malbersmain-netizen/agentpad/schematics.html

# Schematics & board layout

Circuit, pin map, both sides of the board, component detail, every wire, then one figure per solder step.

One double-sided board, 30 × 42 holes. Everything lives on it: the control surface in columns 1–28, the ESP32 in a socket at columns 30–40 with its USB overhanging the edge. All soldering is done on one face, so the design works whether or not the holes are plated through. The ESP32 and the LCD both unplug — only the board is permanent.

Verified in millimetres, not hole counts. Every figure here is generated from tools/layout.py, the same file tools/verify-layout.py checks — so a drawing cannot disagree with the spec. Re-check with mise exec -- python tools/verify-layout.py.

## 1 · Circuit schematic

Three functional groups. LEDs: GPIO → 220Ω → LED → GND. Buttons: GPIO → switch → GND, with the ESP32's internal pull-up doing the rest. LCD: I²C on GPIO 21/22, powered from 5V.

## 2 · Pin map

16 connections. Every GPIO is safe: none are input-only (34-39) or boot strapping pins (0, 2, 12, 15). The 12 signal wires and the ground wire are soldered to socket pads; the LCD's 4 reach the board's LCD port on F-M jumpers.

## 3 · Board layout — top side, finished

One 30×42 double-sided board. The ESP32 is socketed at columns 30-40 on this same board; every wire is drawn on its real route. Red ✕ marks the switch leg you clip off.

## 3b · How it sits on the wood

Two pieces screw to the plate: the board, and the LCD. The ESP32 is socketed on the board itself, USB facing an edge. Only the board is permanent.

## 4 · Underside — where every joint lives

**This view is MIRRORED** — flip the board over and column 1 is on the right, so the numbers run 42 → 1. The board is double-sided, but every joint is made on this one face, which is what makes the design independent of whether your holes are plated through.

## 5 · Component detail — which holes exactly

Each switch has four legs but only two internally-joined pairs — and on this kit they join down the LONG axis. One leg is CLIPPED OFF before seating so the board works either way.

## 6 · Connection list

Tick these off as you go. Label both ends of every wire before you solder the second end.

## Step 1 — the buses and the ESP32 socket

Bare wire along rows 8, 16, 21 (all GND), spanning columns 1-28 and linked down column 1. Then the two 15-way socket strips at columns 30 and 40, rows 8-22. Test: every point on a bus beeps to every other; no bus beeps to a signal row.

## Step 2 — LEDs and resistors

Anode row 2, cathode row 3; the cathode lead bends flat on the copper face onto the row-4 pad, where the 220R starts. The resistor's other lead sits in row 8 — a GND bus — so it grounds itself. Columns 4, 11, 18, 25. Test: plug the ESP32 in, run firmware/ledtest — all four cycle.

## Step 3 — the four colored buttons

Legs in rows 11 and 16, left columns 3, 10, 17, 24 (each spans 2 columns). CLIP the leg at the signal column on row 16 before seating — three legs go in. The row-11 signal leg takes the wire; the diagonally opposite leg lands on the row-16 bus. Test: firmware/btntest prints button 0-3.

## Step 4 — AA / no / yes

Small 3x3 buttons, legs in rows 19 and 21, left columns 4, 13, 22. Same clip-one-leg rule. These are square, so orientation does not matter. Test: btntest prints button 0-6. Several dead at once means the GND bus, not the switches.

## Step 5 — the 12 wires, then the LCD

Every signal wire runs along its own row to the riser lane at column 29, then into its socket pad; the four that serve right-hand pins carry on underneath the module. Last, the 4-pin LCD port at cols 30-33 row 2 and its four wires — the LCD plugs into it on F-M jumpers and is never soldered. Test: firmware/lcdtest prints 'found device at 0x27'.
