malbersmain-netizen/agentpad/daemon.py

"""Agent Pad daemon (self-contained: all control on the board, no game controller).

Flow:
  - Color buttons (serial "B 0".."B 3") launch a color-tinted tmux window running
    `claude` if that agent isn't running yet, then focus it.
  - Approve / Deny buttons (serial "B 4" / "B 5") send a keystroke to the agent whose
    window is on screen -- but ONLY when it is genuinely blocked (safety interlock).
  - Claude Code hooks append to events.jsonl (pane + state); the daemon lights the
    matching LED and updates the LCD.

`blocked` comes from the PermissionRequest hook, which fires exactly when a permission
prompt is shown -- instantly, and for every prompt type. Do NOT switch this back to the
Notification hook: measured on this hardware, Notification fires 6.00s AFTER the prompt
renders (it exists to chase a user who walked away), which made the pad useless.

Run it in its own terminal, then attach to the session in another:
    tmux attach -t agentpad
"""
import json, os, re, time, subprocess, threading
import serial

# ===== CONFIG =====
PORT     = "/dev/cu.usbserial-0001"     # confirmed on this build
SESSION  = "agentpad"                    # tmux session name
APPROVE  = "1"                           # keystroke: "Yes"
DENY     = "3"                           # keystroke: "No"
ALWAYS   = "2"                           # keystroke: "Yes, and don't ask again"
# Agent windows must keep NORMAL permissions even when the user's own settings say
# bypassPermissions -- otherwise nothing ever prompts, `blocked` never fires, and the
# LEDs and approve/deny buttons have nothing to do. This flag is the whole demo.
CLAUDE   = "claude --permission-mode manual"
# Derived from this file's own location, not hardcoded. The repo moved once
# (~/projects -> ~/github) and every absolute path in it had to be chased down; deriving
# means the next move is free.
HERE     = os.path.dirname(os.path.abspath(__file__))
EVENTS   = os.path.join(HERE, "events.jsonl")
CONTEXT  = os.path.join(HERE, "context.jsonl")
LOGFILE  = os.path.join(HERE, "daemon.log")
# per-agent identity (index 0-3 = red, green, blue, yellow)
NAMES  = ["A1-red", "A2-grn", "A3-blu", "A4-ylw"]
COLORS = ["colour52", "colour22", "colour17", "colour58"]  # dark tint per window
STATES = {"none", "idle", "working", "blocked", "done"}
# ==================

ser_lock = threading.Lock()   # serial is shared by several threads
lcd_lock = threading.Lock()   # refresh() writes two rows; keep them as one update
ser = None

def open_serial(quiet=False):
    """Open the board, waiting for it to appear. The ESP32 re-enumerates whenever the
    cable is nudged; a demo should survive that instead of dying at startup."""
    global ser
    while True:
        try:
            ser = serial.Serial(PORT, 115200, timeout=0.1)
            time.sleep(2)                      # board reboots when the port opens
            log(f"serial open on {PORT}")
            return
        except Exception as exc:
            if not quiet:
                print(f"waiting for {PORT} ... ({exc.__class__.__name__})")
                quiet = True
            time.sleep(1)

slots     = [None] * 4     # agent index -> tmux pane id (once launched)
pane_slot = {}             # pane id -> agent index
info      = {}             # pane id -> {"state":..., "since":..., "prev":...}
ctx_pct   = {}             # pane id -> context-window usage %
focus     = 0
gauge_shown = None         # last value sent to the bar graph
answered_at = {}           # pane -> time we last sent a keystroke (double-fire guard)

def log(msg):
    try:
        with open(LOGFILE, "a") as f:
            f.write(f"{time.strftime('%H:%M:%S')} {msg}\n")
    except OSError:
        pass

def send(line):
    with ser_lock:
        try:
            ser.write((line + "\n").encode())
        except Exception:
            pass          # board unplugged; read_serial owns reconnecting

def tmux(*args):
    return subprocess.run(["tmux", *args], capture_output=True, text=True)

def set_state(pane, i, st, keep_prev=None):
    """Record a state change and push it to the LED. Resets the timer only when the
    state actually changes, so repeat events don't restart the clock."""
    prev = info.get(pane)
    if not prev or prev["state"] != st:
        info[pane] = {"state": st, "since": time.time(),
                      "prev": keep_prev if keep_prev is not None
                      else (prev or {}).get("state", "idle")}
    else:
        prev["state"] = st
    send(f"L {i} {st}")

def ensure_session():
    """Create the session (with a placeholder 'home' window) so you can attach
    immediately and watch agent windows appear as you press buttons."""
    if tmux("has-session", "-t", SESSION).returncode != 0:
        tmux("new-session", "-d", "-s", SESSION, "-n", "home")

def sync_slots():
    """Bind each agent window's pane to its slot BY NAME. Authoritative and
    idempotent, so color/slot stays correct even after a daemon restart (when the
    windows already exist and we never re-spawn them)."""
    if tmux("has-session", "-t", SESSION).returncode != 0:
        return
    r = tmux("list-windows", "-t", SESSION, "-F", "#{window_name}\t#{pane_id}")
    if r.returncode != 0:
        return                         # tmux hiccup: keep what we have, never clear
    live = {}
    for line in r.stdout.splitlines():
        parts = line.split("\t")
        if len(parts) != 2:
            continue
        name, pane = parts
        if name in NAMES:
            live[NAMES.index(name)] = pane
    for i, pane in live.items():
        old = slots[i]
        if old and old != pane:
            pane_slot.pop(old, None)   # window respawned: drop the orphan mapping
            info.pop(old, None)
            ctx_pct.pop(old, None)
            answered_at.pop(old, None)
        slots[i] = pane
        pane_slot[pane] = i
    # Close an agent window and its slot used to keep the dead pane forever: the LED
    # stayed lit on a stale state, watch_prompts kept capture-pane'ing a pane that no
    # longer exists, and respond() could aim a keystroke at it. Drop it and dark the LED.
    for i in range(4):
        if i not in live and slots[i]:
            dead = slots[i]
            pane_slot.pop(dead, None)
            info.pop(dead, None)
            ctx_pct.pop(dead, None)
            answered_at.pop(dead, None)
            slots[i] = None
            send(f"L {i} none")
            log(f"agent {i} window closed -- slot released (was {dead})")

def state_of(i):
    p = slots[i]
    return info[p]["state"] if p and p in info else "none"

def refresh():
    letters = {"none": "-", "idle": "i", "working": "w", "blocked": "B", "done": "d"}
    p = slots[focus]
    if p and p in info:
        secs = int(time.time() - info[p]["since"])
        row0 = f"A{focus+1} {info[p]['state'].upper()[:7]} {secs//60}:{secs%60:02d}"
    else:
        row0 = f"A{focus+1} --"
    row1 = " ".join(f"{i+1}{letters.get(state_of(i), '?')}" for i in range(4))
    # "1w 2B 3i 4d" is 11 of 16 chars, so the focused agent's context usage fits in
    # the tail. Costs no hardware, and doubles as a fallback if the bar graph isn't wired.
    used = ctx_pct.get(p) if p else None
    if used is not None:
        row1 = f"{row1} {used}%"
    # Both rows as one unit. refresh() is called from four threads, and interleaving
    # two calls leaves row 1 describing a state row 0 has already moved past.
    with lcd_lock:
        send(f"D0 {row0[:16]}")
        send(f"D1 {row1[:16]}")

def _spawn(i):
    """Create the tmux window for agent i running claude; record its pane id."""
    if tmux("has-session", "-t", SESSION).returncode != 0:
        r = tmux("new-session", "-d", "-s", SESSION, "-n", NAMES[i],
                 "-P", "-F", "#{pane_id}", CLAUDE)
    else:
        r = tmux("new-window", "-t", SESSION, "-n", NAMES[i],
                 "-P", "-F", "#{pane_id}", CLAUDE)
    pane = r.stdout.strip()
    if pane:
        slots[i] = pane
        pane_slot[pane] = i
    # tint the whole window so you can tell agents apart at a glance
    tmux("set-option", "-w", "-t", f"{SESSION}:{NAMES[i]}", "window-style",
         f"bg={COLORS[i]}")

def launch_or_focus(i):
    global focus
    wins = []
    if tmux("has-session", "-t", SESSION).returncode == 0:
        wins = tmux("list-windows", "-t", SESSION,
                    "-F", "#{window_name}").stdout.splitlines()
    if NAMES[i] not in wins:
        _spawn(i)
    sync_slots()   # keep color/slot binding authoritative
    tmux("select-window", "-t", f"{SESSION}:{NAMES[i]}")
    focus = i
    refresh()

def active_slot():
    """Agent slot whose tmux window is currently active, or None if not an agent
    window. Lets the pad follow tmux even when you switch windows by hand."""
    name = tmux("display-message", "-p", "-t", SESSION, "#{window_name}").stdout.strip()
    return NAMES.index(name) if name in NAMES else None

# A selection prompt renders as numbered option rows with a ">" cursor on the current
# one. Matching that STRUCTURE (rather than wording) covers every prompt shape --
# tool permission, plan approval, compaction, trust dialogs, AskUserQuestion -- without
# depending on prose that Claude might merely be talking about.
OPTION_RE   = re.compile(r"^\s*❯?\s*[1-9]\.\s+\S")   # "  2. No"
SELECTED_RE = re.compile(r"^\s*❯\s*[1-9]\.\s+\S")    # "❯ 1. Yes"  <- only a live menu

def prompt_visible(pane):
    """True if a live selection prompt is on that pane's screen RIGHT NOW.

    Requires a selected option row AND at least two options. The input box also
    starts with "❯", so the cursor alone is not enough -- it must sit on a numbered
    option, which normal output never does.
    """
    r = tmux("capture-pane", "-p", "-t", pane)
    if r.returncode != 0:
        return False
    lines = r.stdout.splitlines()
    # Claude Code pads the screen with blank lines BELOW the prompt -- 17 of them on a
    # 42-row pane, measured. Taking a fixed tail of the raw capture then slices the
    # prompt in half: you see "3. No" but not the "> 1. Yes" selected row above it, and
    # conclude nothing is waiting. Trim the padding first, then look at real content.
    while lines and not lines[-1].strip():
        lines.pop()
    tail = lines[-20:]
    return (any(SELECTED_RE.match(l) for l in tail)
            and sum(1 for l in tail if OPTION_RE.match(l)) >= 2)

def respond(keystroke):
    """Answer the prompt on the agent that is actually on screen."""
    global focus
    i = active_slot()
    if i is None:
        # not looking at an agent window -- refuse rather than guess a target
        log(f"respond({keystroke!r}) refused: active window is not an agent")
        send("D0 no agent focused")
        time.sleep(0.6)
        refresh()
        return
    focus = i
    p = slots[focus]
    # Small grace window: the hook and the button race by a few ms.
    if p and info.get(p, {}).get("state") != "blocked":
        deadline = time.time() + 0.4
        while time.time() < deadline and info.get(p, {}).get("state") != "blocked":
            time.sleep(0.02)
    st = info.get(p, {}).get("state") if p else None
    snapshot = {k: v["state"] for k, v in list(info.items())}
    # Two independent conditions must agree before we type anything: the hook says
    # blocked AND a prompt is on screen right now. Either alone can be stale.
    on_screen = prompt_visible(p) if p else False
    log(f"respond({keystroke!r}) slot={i} pane={p} state={st} on_screen={on_screen} "
        f"info={snapshot}")
    if not p or st != "blocked" or not on_screen:
        send("D0 not blocked")
        time.sleep(0.6)
        refresh()
        return
    r = tmux("send-keys", "-t", p, keystroke, "Enter")
    # Clear immediately so a second press can't re-fire into the now-normal input box.
    # The screen does not clear instantly though, so also suppress screen-detection on
    # this pane briefly -- otherwise the next 200ms poll still sees the old menu, marks
    # it blocked again, and a double press types a second keystroke into whatever has
    # replaced the prompt.
    answered_at[p] = time.time()
    set_state(p, i, "working")
    refresh()
    log(f"  sent {keystroke!r} to {p} rc={r.returncode} err={r.stderr.strip()!r}")

def slot_of(pane):
    """Map a hook's pane to an agent slot. Only panes we launched count -- the hooks
    are global, so every Claude session on the machine writes to events.jsonl and a
    stranger must never be able to claim a slot (or receive our keystrokes)."""
    return pane_slot.get(pane)

def tail_events():
    open(EVENTS, "a").close()
    with open(EVENTS, "r") as f:
        f.seek(0, 2)
        while True:
            # Remember where we were BEFORE reading. A text-mode file cannot do
            # cur-relative seeks -- f.seek(-len(line), SEEK_CUR) raises
            # UnsupportedOperation -- and len() counts characters, not bytes, so even
            # a binary handle would misalign on non-ASCII. tell()/seek() is the only
            # correct way to rewind past a partial write.
            pos  = f.tell()
            line = f.readline()
            if not line or not line.endswith("\n"):
                f.seek(pos)                  # partial write: re-read it whole next time
                time.sleep(0.02)
                continue
            try:
                e = json.loads(line)
            except Exception:
                continue
            pane = e.get("pane")
            if not pane:
                continue
            i = slot_of(pane)
            if i is None:
                continue
            st = e.get("state", "idle")
            if st not in STATES:
                continue
            set_state(pane, i, st)
            log(f"event pane={pane} slot={i} state={st}")
            refresh()

def read_serial():
    while True:
        try:
            line = ser.readline().decode(errors="ignore").strip()
        except Exception:
            log("serial lost -- reopening")
            try:
                ser.close()
            except Exception:
                pass
            open_serial(quiet=True)
            blank_leds()
            resync_leds()
            global gauge_shown
            gauge_shown = None
            push_gauge()
            continue
        if not line.startswith("B "):
            continue
        try:
            n = int(line.split()[1])
        except (IndexError, ValueError):
            continue
        if   0 <= n <= 3: launch_or_focus(n)
        elif n == 4:      respond(APPROVE)
        elif n == 5:      respond(DENY)
        elif n == 6:      respond(ALWAYS)

def watch_prompts():
    """Keep `blocked` in sync with what is actually on screen.

    PermissionRequest covers tool permissions instantly, but it is NOT the only thing
    that stops an agent: compaction dialogs, plan approval, trust prompts and
    AskUserQuestion all wait on you without being a tool permission. Matching the
    on-screen menu catches those too (within one 200ms poll), and also notices when
    any prompt has been answered.
    """
    while True:
        time.sleep(0.2)
        for i, p in enumerate(list(slots)):
            if not p:
                continue
            if time.time() - answered_at.get(p, 0) < 1.0:
                continue                  # just answered; let the screen catch up
            cur = info.get(p, {}).get("state")
            vis = prompt_visible(p)
            if vis and cur != "blocked":
                set_state(p, i, "blocked")
                log(f"screen-detect BLOCKED pane={p} slot={i} (was {cur})")
                refresh()
            elif not vis and cur == "blocked":
                back = info.get(p, {}).get("prev") or "working"
                if back == "blocked":
                    back = "working"
                set_state(p, i, back)
                log(f"prompt cleared pane={p} slot={i} -> {back}")
                refresh()

def push_gauge():
    """Drive the bar graph like a BATTERY: full = fresh context, empty = context spent.

    ctx_pct stores context *used*, so the lit portion is the remainder. An agent we
    have no reading for yet shows dark rather than falsely full.
    """
    global gauge_shown
    p = slots[focus]
    used = ctx_pct.get(p) if p else None
    charge = 0 if used is None else max(0, min(100, 100 - used))
    if charge != gauge_shown:
        gauge_shown = charge
        send(f"G {charge}")
        log(f"gauge slot={focus} used={used} -> charge {charge}%")

def tail_context():
    """Follow context.jsonl, written by the statusLine command in each agent."""
    open(CONTEXT, "a").close()
    with open(CONTEXT, "r") as f:
        f.seek(0, 2)
        while True:
            pos  = f.tell()                  # see tail_events: no cur-relative seeks
            line = f.readline()
            if not line or not line.endswith("\n"):
                f.seek(pos)
                time.sleep(0.1)
                continue
            try:
                e = json.loads(line)
                pane, pct = e["pane"], int(e["pct"])
            except Exception:
                continue
            if pane in pane_slot:
                ctx_pct[pane] = max(0, min(100, pct))
                push_gauge()

def tick():
    """Re-render the LCD every second so the state timer counts live, and follow
    whichever agent window tmux has active (you may switch windows by hand)."""
    global focus
    while True:
        time.sleep(1)
        sync_slots()          # notice windows the user closed by hand
        i = active_slot()
        if i is not None and i != focus:
            focus = i
        refresh()
        push_gauge()   # bar follows whichever agent you're looking at

def resync_leds():
    """Push current states to the board. Used after a reconnect, since the ESP32
    reboots with every LED off and no memory of what we last told it."""
    for i, p in enumerate(slots):
        if p and p in info:
            send(f"L {i} {info[p]['state']}")
    refresh()

def blank_leds():
    """Turn all four LEDs off. The ESP32 holds its last-known LED state across
    daemon restarts, so without this a fresh start shows stale lights."""
    for i in range(4):
        send(f"L {i} none")

def recover_state():
    """Rebuild last-known agent state from the events log so a daemon restart is
    seamless. `blocked` is deliberately NOT restored: a prompt from a previous run is
    long gone, and reviving it would open the interlock with nothing on screen."""
    try:
        # Only the tail matters -- this file is append-only across every session on the
        # machine and grows without bound, and the last state per pane is all we want.
        lines = open(EVENTS).read().splitlines()[-500:]
    except FileNotFoundError:
        return
    for line in lines:
        try:
            e = json.loads(line)
        except Exception:
            continue
        pane, st = e.get("pane"), e.get("state", "idle")
        if pane in pane_slot and st in STATES and st != "blocked":
            info[pane] = {"state": st, "since": time.time(), "prev": st}
    for pane, i in pane_slot.items():
        if pane in info:
            send(f"L {i} {info[pane]['state']}")

def supervise(fn):
    """Keep a worker alive. Without this one exception silently half-kills the daemon
    (e.g. buttons stop working) while the process still looks healthy."""
    def wrapper():
        while True:
            try:
                fn()
            except Exception as exc:
                log(f"!! {fn.__name__} crashed: {exc!r} -- restarting in 1s")
                time.sleep(1)
    return wrapper

open_serial()     # waits for the board rather than dying if it's unplugged
ensure_session()
blank_leds()      # clear stale LED state the board held from a previous run
sync_slots()      # bind existing agent windows to their color slots on startup
recover_state()   # restore last-known LED states (never `blocked`) after a restart
for worker in (tail_events, tail_context, read_serial, tick, watch_prompts):
    threading.Thread(target=supervise(worker), daemon=True).start()

refresh()
print("agentpad running. ctrl-c to quit.")
print(f"attach the board's sessions with:  tmux attach -t {SESSION}")

try:
    while True:
        time.sleep(0.2)
except KeyboardInterrupt:
    pass
finally:
    try:
        ser.close()
    except Exception:
        pass
