malbersmain-netizen/agentpad/(commit log)

2026-07-28 Initial commit: Agent Pad firmware, docs, and software scaffold
    Hardware build verified end-to-end (LCD, 4 LEDs, 4 buttons, serial protocol).
    - firmware/agentpad: real firmware (compiles + runs on ESP32)
    - firmware/{blink,lcdtest,ledtest,btntest}: milestone test sketches
    - daemon.py, pad.py, test.py: software scaffold (Milestones 6-9)
    - CLAUDE.md, agentpad-build-guide.md: project docs
    - mise.toml: Python 3.13 venv (pyserial, pygame)
2026-07-28 Self-contained control surface: 6 buttons, no game controller
    Redesign so the board alone drives everything (a true 'code micro' clone):
    - Firmware: 6 buttons (added APPROVE=GPIO19, DENY=GPIO18); protocol now B 0-5
    - Daemon: color buttons launch a color-tinted tmux 'claude' window and focus it;
    approve/deny send keystrokes to the focused agent behind the blocked interlock
    - Drop pygame from the daemon (pad.py kept for a possible later add-on)
    Fixes found during hardware testing:
    - Live 1s LCD timer, anchored to state CHANGE so repeat hook events don't reset it
    - sync_slots(): bind pane->slot by window name, so color/slot mapping survives a
    daemon restart (this was silently breaking appr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
    [agentpad.ino, daemon.py]
2026-07-28 Fix approve/deny race and follow the active tmux window
    Two real bugs found by instrumenting the daemon:
    1. Approve/deny targeted the last color button pressed, not the window actually
    on screen. Switching windows inside tmux aimed the keystroke at the wrong
    agent. Now resolved from tmux active window; the LCD follows it too.
    2. Race: the permission prompt renders slightly BEFORE the Notification hook
    reaches the daemon, so pressing approve immediately was refused on stale
    state (log showed refuse -> blocked event -> accept, all in one second).
    The interlock now waits up to 1.5s for to arrive. It still never
    sends a keystroke unless the agent really is blocked.
    Adds dae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
    [daemon.py]
2026-07-28 Detect blocked from the screen, not the Notification hook (6.00s -> 0.24s)
    Measured on real hardware: the Notification hook fires 6.00s AFTER the permission
    prompt renders. That is by design -- notifications exist to chase a user who has
    walked away -- but it is far too slow for a status light, and it was the actual
    cause of "approve does not work": the pad was still showing the previous state
    when the user's thumb got there.
    Fix: poll each agent pane with tmux capture-pane (200ms) and treat a visible
    permission prompt as authoritative for `blocked`. Hook `blocked` events are now
    ignored entirely so the stale 6s-late event cannot re-trigger after the prompt is
    answered; hooks still drive id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
    [daemon.py]
2026-07-28 Remove the controller entirely; bring docs in line with the built device
    The device is a single self-contained unit, so the game-controller path is gone
    rather than deferred: delete pad.py, drop pygame from the dependencies, and strip
    the controller from both docs.
    Docs were describing the original design and would not have produced a working
    build. Rewrote agentpad-build-guide.md against the real implementation:
    - six buttons throughout, with APPROVE=GPIO19 / DENY=GPIO18 added to the pin
    table and the test sketch (the guide previously never had you wire them at all)
    - deleted the obsolete pygame daemon listing; daemon.py is now described, not
    duplicated, so it cannot drift again
    - the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
2026-07-28 Catch non-permission dialogs, add always-allow button, feed context% to a gauge
    PermissionRequest only covers TOOL permissions. Compaction dialogs, plan approval,
    trust prompts, /model and AskUserQuestion all block an agent without being a tool
    permission, so the LED stayed dark and approve/deny refused. The screen watcher now
    SETS blocked as well as clearing it, matching menu structure rather than wording.
    Verified against /model (fires no PermissionRequest): "screen-detect BLOCKED".
    To keep that from false-positiving on Claude's own prose, a match now requires the
    cursor to sit ON a numbered option ("> 1. Yes"), not merely a numbered list -- the
    input box also starts with ">", so the curs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
2026-07-28 Show context % on the LCD; descope the bar graph; add BUILD.md
    Context-window usage now appears on the LCD bottom row ("1w 2B 3i 4d 34%"), which
    needs no hardware at all -- the row was only using 11 of 16 characters. Sourced from
    the statusLine payload, the one place Claude Code exposes context_window usage.
    Bar graph descoped at the user's request: it needed a 74HC595 (the kit is a Raspberry
    Pi kit, which has enough GPIOs to drive all 10 segments directly -- we don't), plus
    board space that is already spoken for. The firmware keeps the `G` command and
    reserves GPIO 5/16/17, so it can be added later without touching anything else.
    BUILD.md: checklist for the soldered/cased build. Two rules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
2026-07-28 BUILD.md: mounting decision, shopping list, wiring harness map, solder order
    Adds the full harness table (15 signal wires with suggested colors and labels), a
    bus-first perfboard strategy mirroring the breadboard rails, and a 7-step solder
    order where each step has an explicit pass condition using the existing milestone
    sketches.
    Mounting is decided by the kit: its buttons and LEDs are breadboard parts with no
    collar or bezel, so they must be board-mounted poking through the face, while the
    LCD has mounting holes and panel-mounts on flying leads. Since we are designing the
    case, it should be laid out on the perfboard's 0.1in grid so alignment is guaranteed
    rather than hoped for. Records the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
2026-07-28 Add tools/view-plan.py: render BUILD.md as a tickable bench checklist
    Renders BUILD.md (still the single source of truth -- no duplicated copy to drift)
    into a styled page with per-row checkboxes that persist in localStorage, so the build
    can be ticked through across sessions. Light/dark aware and printable.
    mise exec -- python tools/view-plan.py
2026-07-28 Add illustrated build figures; record case fit findings
    tools/build-figures.py draws the case to scale and one figure per solder step
    (header+buses, LCD, LEDs, buttons) plus detail insets for LED polarity, the button
    diagonal-leg rule, and good vs cold joints.
    Checking the 95x140x28mm design against real part dimensions found two problems:
    - Depth: stacking the ESP32 under the perfboard needs 32.7mm and will not close in a
    28mm case. Coplanar comes to 24.2mm. The ESP32 therefore needs a ~30x60mm free zone;
    the empty middle band is ~24mm today and should be opened up.
    - LCD: the 80x36mm figure is the MODULE outline. Cutting that size drops the module
    through the face. The window shoul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
2026-07-28 BUILD.md: rewrite as a complete end-to-end build manual
    Previous version was a checklist plus figures, not an instruction set. Now covers the
    whole path: parts, case spec with real hole coordinates, perfboard grid plan, a
    soldering primer for a first-timer, seven build steps each with a pass condition,
    case assembly, software install, an acceptance test, and troubleshooting.
    Corrects an earlier claim: the middle band does NOT need opening. Working out real
    coordinates shows the ESP32 fits vertically in the bottom-centre with AA to its left
    and no/yes to its right -- which is how the case was already drawn. Depth still
    requires it coplanar rather than stacked (24.2mm vs 32.7mm in a 28mm case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
2026-07-28 Add printable 3D case (OpenSCAD) and an assembly guide
    case/agentpad-case.scad: parametric two-part enclosure -- printed face plate with all
    cutouts, and a box with walls, board standoffs, corner posts and a USB slot. Renders to
    face.stl / box.stl (gitignored; regenerate from the .scad).
    Render headless (Qt needs a display otherwise):
    QT_QPA_PLATFORM=offscreen openscad -o face.stl -D 'PART="face"' case/agentpad-case.scad
    The model computes its own depth and reports the fit. Two findings from it:
    - Total thickness 25.2mm, so the 28mm design has room.
    - The face gap is set by the ESP32 (13.6mm), not the button caps (12.5mm), so the
    buttons need a ~1.1mm shim -- or 5mm low-profile headers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
    [agentpad-case.scad]
2026-07-28 Correct the perfboard claim; document the 3mm span problem
    The kit DOES include three PY-5CM*7CM perfboards -- my earlier claim that it only
    had a solderless breadboard was wrong, taken from a contents sheet that listed only
    the Project Board.
    They are still unusable here, but for a different and more concrete reason: the
    select-button row spans 73mm outer-edge and the answer row 75.5mm, while the widest
    kit board is 70mm. Button positions are fixed by the case face, so this is geometry,
    not packing. Records the three ways out (buy one 9x15cm, narrow the pitch to 7 holes
    and re-render the case, or split across boards with wire looms).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
2026-07-28 Narrow pitch to 6 holes (15.24mm) to fit the kit's 18x24 perfboards
    Board confirmed as 18 x 24 holes (a-x by 1-18), so the hole field is 58.4mm and the
    old 8-hole pitch (73mm span) was never going to work. Pitch is now driven by a single
    PITCH_HOLES parameter in the .scad; every hole position and the answer-row placement
    derive from it, so the face and the board grid stay in agreement.
    New columns: 24.64 / 39.88 / 55.12 / 70.36mm. AA sits under column 1 and no/yes under
    columns 3 and 4, which keeps AA 30.5mm away from 'yes' so it can't be fat-fingered.
    Consequence to design around: at 18 rows per board, no single kit board can hold the
    LED/button cluster (9 rows), the ESP32 (15 rows) and t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
    [agentpad-case.scad]
2026-07-28 Single-board layout: everything fits on one kit board after all
    I was wrong twice about this. First I said the kit had no perfboard; it has three.
    Then I said the design needed splitting across three of them. Both wrong.
    It fits on ONE 18x24 board because the ESP32 is socketed and hangs UNDERNEATH -- it
    consumes only two rows of holes (the header) instead of an 11x15 block of top-side
    area. Rows 2 and 11 carry the header; the LED/button clusters are placed specifically
    to leave those two rows free. Button legs protrude ~3mm below the board and the ESP32
    sits 8.5mm below on its header, so nothing collides. The ESP32's USB overhangs the
    board edge, which makes the cable easier to reach, not h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
2026-07-28 Verify the single-board layout, add schematics and a soldering course
    tools/verify-layout.py checks the layout in millimetres rather than hole counts -- a
    12mm button body is 4.7 holes wide, so parts collide even when their legs sit in free
    holes. It immediately caught one: the standing 220R and the LED body fought for the
    same column. Resistors moved two columns right; now PASS, with 3.2mm between button
    caps, 2.9mm LED->button and 6.2mm between the two banks.
    Confirmed: all 7 buttons, 4 LEDs, 4 resistors and the ESP32 fit ONE 18x24 kit board.
    tools/schematic.py draws the circuit schematic, the finished board, and one board
    figure per solder step, all from the same layout data the verifie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
    [schematic.py, verify-layout.py]
2026-07-28 Correct button footprints to measured values; expand the schematic set
    Measured on the real parts: the colored buttons' legs are 5 holes apart in BOTH
    directions (a 5x5 span, 12.7mm), not the 2-hole span I had modelled, and the small
    buttons are 3x3. Re-verified against those numbers.
    It still fits one board, and the column arithmetic turns out to be exact: four buttons
    with 5-hole legs at a 6-column pitch occupy columns 1-6, 7-12, 13-18, 19-24 -- all 24
    columns with nothing to spare. Clearances improved: 3.2mm between button bodies, 4.2mm
    LED->button, 7.5mm between banks. Row plan is now
    1 res | 2 HEADER | 3-4 LED | 5 GND | 6-11 buttons | 12 HEADER | 14-16 answers | 17 GND | 18 5V+LCD.
    Sc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
    [schematic.py, verify-layout.py]
2026-07-28 Use the measured button pin geometry (3 across x 6 long)
    Third correction to these footprints, and this one is from calipers rather than a
    datasheet guess: the colored buttons' pins are 3 holes ACROSS (2 pitches, 5.08mm) and
    6 holes LONG (5 pitches, 12.7mm) -- a rectangle, not the 5x5 square I had modelled.
    Small buttons are 3x3.
    This is better than the previous model. Legs now occupy only 3 columns each, so the
    board is no longer packed to exactly 24 columns; the 12mm bodies overhang their own
    legs and sit 3.24mm apart. The header moved to rows 4 and 13, which frees rows 1-3
    entirely for the LEDs and their resistors and keeps both header rows clear of every
    component body. LED->button clea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
    [schematic.py, verify-layout.py]
2026-07-28 Add BREADBOARD.md; re-solve the row plan for 1.0in ESP32 pin rows
    The ESP32 measures 11 holes across x 15 long, so its pin rows are 10 apart (1.0 inch),
    not the 0.9 inch I had assumed. That invalidated the header placement. Rather than
    guess again, a small search enumerated every arrangement satisfying all the physical
    constraints -- header rows exactly 10 apart, both clear of leads AND not sitting under
    any component body (their solder joints protrude on the top side, so a button resting
    on them would not lie flat). Exactly two arrangements survive; this is the roomier one.
    Row plan: 1 5V | 2 resistors (flat) | 3-4 LEDs | 5 GND | 6 HEADER-A |
    7+12 button legs | 13+15 answer legs | 16 HEADE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
2026-07-28 Header is a stacking type: document orientation and the alignment trick
    The kit's 40-pin header has sockets on one face and long pins on the other. It works,
    but the orientation is counter-intuitive and effectively one-way: the strips go in from
    UNDERNEATH so the pins come up through the board and the sockets hang below, then get
    soldered from the top and trimmed. Sockets facing down is what lets the ESP32 plug in
    from below, which is the only reason the whole design fits one board.
    Also records the assembly order that makes misalignment impossible: plug both strips
    onto the ESP32 first and insert the assembly as one unit, so the ESP32 itself holds the
    spacing and squareness while you solde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
2026-07-28 Two-board build on a wooden plate; single-sided board drives the design
    The kit's perfboards are SINGLE-SIDED -- copper on one face only, so every joint is on
    that face and components sit on the other. I had assumed plated-through and never
    checked, which invalidated the socket placement: the ESP32's socket body would have
    had to sit on the copper face, covering the pads it needs soldered to. It cannot go on
    top either -- it spans 11 of the 18 rows and 14 are needed.
    Resolution: the ESP32 gets its OWN kit board, where the header mounts the normal way
    round (body on top, pins down, soldered on the copper underside). 15 wires join the
    two boards, and both screw to a wooden backing plate along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
2026-07-28 Bypass permissions globally, but keep agent windows prompting
    Set permissions.defaultMode to bypassPermissions so the user is not asked to approve
    routine work. That alone would have gutted the device: no prompt means no
    PermissionRequest hook, so the LEDs never blink and approve/deny/always-allow have
    nothing to answer. The daemon therefore launches every agent window with an explicit
    --permission-mode flag so those sessions still prompt normally.
    The flag value is `manual`, not `default` -- the CLI has no "default" choice
    (acceptEdits, auto, bypassPermissions, manual, dontAsk, plan). Verified by launching a
    session: it reports "manual mode on". Had this shipped as written, every agent win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
2026-07-28 Fix btntest (only read 4 of 7 buttons) and stale CLAUDE.md protocol
    A review pass found btntest.ino still declared BTN[4] and printed "PRESS 1 RED (32)",
    while BUILD.md's step 5 told the builder to expect "button 0 ... button 6". Following
    the doc, three correctly-soldered buttons would have printed nothing and sent the
    builder hunting a ground fault that did not exist -- at night, against a deadline.
    It now reads all seven and prints the exact strings the step expects.
    CLAUDE.md was stale in ways that would corrupt a regeneration: the serial protocol
    said B <0-5> with 4=approve, 5=deny, but the firmware emits B 0-6 and the daemon
    handles n==6, so always-allow would have been dropped. Also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
    [btntest.ino]
2026-07-28 Fix connectivity errors the new verifier caught; act on the review
    The verifier now checks NETS, not just geometry, and immediately found two places where
    parts were wired to nothing -- exactly the class of error that transfers badly from a
    breadboard, where holes in a row are joined for you and on perfboard they are not:
    - resistors sat in different holes from the LED anodes
    - answer-button ground legs sat in row 17 with the bus in row 18
    Reworked so every net is real: the resistor now stands in the LED's OWN column with its
    top lead sharing the cathode hole, and the button banks moved so every ground leg lands
    directly ON a bus row. That removes all four ground jumpers. Three GND buses (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
    [schematic.py, verify-layout.py]
2026-07-28 Make the LED/resistor net buildable; catch signal-on-bus; draw board B and the assembly
    A second review found the previous "fix" was not physically buildable and that the
    verifier still passed a layout that shorts every button to ground.
    NOT BUILDABLE, now fixed: the LED cathode and the resistor's top lead were told to
    share one hole. A kit hole is 1.0mm and two leads are ~1.25mm side by side, and that
    row-3 hole sat directly under the LED's 6mm flange. LEDs moved to rows 1-2 so the
    cathode lead bends over on the copper face to meet the resistor's pad instead. One
    lead per hole everywhere.
    FALSE PASS, now fixed: the verifier only checked that GROUND legs were on a bus, never
    that SIGNAL le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
    [schematic.py, verify-layout.py]
2026-07-28 Generate the volatile docs from one layout file; drop the 3D-printing work
    The layout drifted from the docs four times. The last time, BUILD.md's wire table sent
    seven SIGNAL wires to GND bus rows -- following it would have shorted every button to
    ground and presented as the exact "several buttons dead" failure the docs warn about.
    Root cause was duplication: three files each kept their own copy of the rows, columns
    and GPIOs. Fixed structurally rather than by editing more carefully:
    - tools/layout.py is now the single source of truth.
    - verify-layout.py, schematic.py and the new gen-tables.py all import from it.
    - BUILD.md's row plan, wire table and joint count live between <!-- GEN:... -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
    [agentpad-case.scad]
2026-07-28 Add CONNECTIONS.md and generate genuinely step-by-step build actions
    The docs said WHAT connects to what and never HOW you physically make a connection --
    the actual blocker for someone who has not built on perfboard before.
    CONNECTIONS.md covers the five moves the whole build is made of: seating a component,
    laying a bus, bending a leg onto a neighbouring pad, running a wire between boards, and
    lap-soldering onto an existing joint. It opens with the idea everything rests on -- a
    perfboard hole is an island, nothing is connected until you connect it -- and ends by
    tracing one complete LED circuit from GPIO through to ground so the reader can see every
    join they will have made.
    It also expl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
2026-07-28 Single board on the new 30x42 double-sided PCB
    The new board is 30 x 42 holes (~79 x 109mm) -- nearly 3x the area of the kit's boards,
    and double-sided. That collapses the two-board split back into one.
    The ESP32 no longer needs any trick: it sits BESIDE the controls in an ordinary socket,
    body on top, pins soldered underneath, at columns 30-40. The control surface occupies
    columns 1-28. Because every joint still stays on one face, the design does not depend on
    whether the holes are plated through -- that is a bonus, not a requirement.
    Dropped: the second board, the inter-board loom, and ~30 joints. Gained: roughly double
    every clearance --
    old 18x24 now
    between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
    [gen-tables.py, layout.py, schematic.py, verify-layout.py]
2026-07-28 Redraw the whole board for one 30x42 double-sided PCB
    The assembly figure still showed the ESP32 on a separate "board B" on the
    plywood, and no figure showed where a signal wire actually goes.
    - fig_assembly: one board + the LCD, ESP32 socketed on it, USB overhanging
    - fig_boardB: deleted, along with every "board A/B" string in the tools
    - board(5): every wire drawn on its real route -- along its own row, up the
    riser lane at col 29, into its socket pad; the four that serve right-hand
    pins carry on dashed underneath the module. Strands are fanned so 11 wires
    read as 11, each numbered to match the BUILD.md wire table
    - socket: all 30 pads drawn and named, used ones highlighted
    - unders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
2026-07-28 Two design review passes: LCD port, real mount holes, step-by-step rebuild
    Review found two things that would have stopped the build dead:
    1. THE LCD HAD NOWHERE TO PLUG IN. Every doc said "4 jumpers onto the
    ESP32's own pins" -- but those pins are inside the socket the moment
    the module is seated, so nothing can clip onto them. Added a 4-pin
    male LCD port on the board (cols 30-33, row 2) wired to the socket
    pads; the LCD reaches it with F-F jumpers and is still never soldered.
    Row 2 is the only band at those columns that clears the module, whose
    55mm body overhangs its pin rows by ~4 rows at each end.
    2. THE MOUNTING HOLES COULD NOT BE DRILLED. The grid spans 104.1 x 73.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
2026-07-28 Add MULTIMETER.md — from-zero meter guide
    Every test in BUILD.md and SOLDERING.md says "beep it" and nothing ever
    explained how. Covers the jacks (including not using the 10A one),
    continuity vs diode mode, the switch pair test that gates the whole
    build, LED polarity, resistor checking, and the three checks that repeat
    all build. Linked from the parts list, the pre-flight section and the
    soldering course.
    Claude-Session: https://claude.ai/code/session_01PWKhYQrJFCVPvunxqV5g9J
2026-07-28 Switches go in with three legs, not four — measured, then made moot
    Meter says the kit's tactile switches join their pairs the LONG way, down
    the columns. The layout assumed the short way, and step C said "solder
    all four legs" — which would have put the signal node straight onto the
    ground bus and welded all seven buttons closed.
    Rather than change the footprint to match one measurement, clip one leg:
    the one in the signal column on the ground-bus row. The hole positions do
    not move at all. verify-layout now simulates BOTH pairings for every
    switch and asserts, in each case, that no soldered signal leg reaches a
    bus, that a soldered ground leg does reach one, and that the wire lands
    on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
    [gen-tables.py, layout.py, schematic.py, verify-layout.py]
2026-07-28 Real board is 120x80mm with factory corner holes; repo-wide consistency sweep
    Photo of the actual PCB: silkscreen reads 12*8CM 2.54MM, and it has four
    mounting holes already drilled outside the pad grid. Column labels run
    A-Z then A-P = 42, matching the layout.
    - BOARD_W/H 109x79 -> 120x80. Margins go from 2.4/2.7mm to 7.9/3.2mm.
    - Mounting switches to the factory corner holes (M3, no drilling). The
    computed drill positions stay as a verified fallback.
    - Pre-flight P4 changes from "drill the mount holes" to "check the board
    is what the layout thinks it is" -- dimensions, grid count, and
    critically: beep adjacent pads to confirm they are ISOLATED, and beep
    the elongated edge pads to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
2026-07-28 Second sweep: two stale-artifact removals, one wrong count, two new checks
    Orphans:
    - assembly-guide.html and build-figures.html were still tracked, but their
    generators (tools/assembly-figures.py, tools/build-figures.py) were
    deleted in the redesign. Both date from before the 30x42 board and still
    depict a 5V bus the design no longer has. Removed.
    - assembly-preview.png was tracked while board-preview.png was gitignored
    by `board-*.png`. Both are generated; both are ignored now.
    Wrong number:
    - The joints table still counted 7 switches x 4 legs. We clip one leg per
    switch, so it is 3: component legs 44 -> 37, total ~156 -> ~149. The
    count is now derived from switch_legs() rathe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
    [gen-tables.py, verify-layout.py]
2026-07-28 Record the measured board check: isolated pads, no edge rails
    Meter on the real 120x80 board: adjacent pads do not beep, and the
    elongated edge pads do not beep to each other. So it is true perfboard,
    not stripboard, and those edge pads are individual rather than power
    rails -- which is what makes column 1 safe for the bare GND link.
    Also added the positive control to pre-flight P4. "No beep" and "probes
    not making contact" look identical, so the step now says to prove the
    meter reads by beeping both probes on one pad ring before trusting any
    silent reading.
    Claude-Session: https://claude.ai/code/session_01PWKhYQrJFCVPvunxq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
2026-07-28 ESP32 was seated backwards: all 12 wire destinations were wrong
    Transcribed pinout from the real module, with the USB at the VIN / 3V3
    end. layout.py said "position 1 = top, USB at the bottom" -- exactly
    inverted. Position 1 IS the USB end, so the numbering runs the other way
    down the socket, and on a DevKit V1 seated USB-down the 3V3 column is on
    the left, not the VIN column. Both the row mapping and the column mapping
    were wrong, so every one of the 12 wires pointed at the wrong pad. D13
    moves row 10 -> row 20 and col 30 -> col 40, and so on.
    Named the sides after their power pin rather than LEFT/RIGHT, because
    left and right swap the instant you turn the module round -- which is how
    this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
    [gen-tables.py, layout.py, schematic.py, verify-layout.py]
2026-07-28 Answer two build questions in the docs: jumper reuse, and socket lap joints
    - Materials: you can cut up the kit's breadboard jumpers for the 16 signal
    wires. Two exceptions called out: keep 4 F-F intact for the LCD, and do
    not use stranded for the buses (a bare stranded wire frays and one stray
    strand is an unfindable short). Also points at the free bus wire nobody
    thinks of: the clipped resistor and LED leads.
    - CONNECTIONS.md Move 5 now leads with the misconception instead of
    assuming it away: you do NOT solder a male pin onto the socket. The
    female strip is an ordinary component -- top side, its own pins through
    the board, soldered underneath. Added a side-view diagram.
    -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
    [gen-tables.py]
2026-07-28 "The copper face" meant something on a single-sided board; it doesn't now
    Prompted by a good question: are the ground buses only soldered on the
    bottom? Yes -- but the docs said "the copper face" in nine places, which
    was a precise instruction when the kit boards were single-sided and is
    meaningless on a double-sided one, where BOTH faces have a pad on every
    hole.
    Normalised to "the underside" everywhere, in the docs and the generators,
    and CONNECTIONS.md now says so explicitly up front: the underside is the
    face you solder on, every joint in the build is made there including all
    three ground buses, and the top pads are simply left bare. Also fixed the
    island diagram, which still drew the t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
    [gen-tables.py, layout.py, schematic.py]
2026-07-28 The underside figure was labelled "mirrored" and wasn't
    Three bugs, all in the one drawing:
    1. It printed "UNDERSIDE — mirrored" while using the same X mapping as the
    top view, so column 1 stayed on the left. Flip the real board over and
    column 1 is on the RIGHT. Anyone laying out the underside against that
    figure would have built the whole board backwards. It is now genuinely
    mirrored, with the column ruler running 42 -> 1 and a red banner saying
    so.
    2. The bus link was drawn at a hardcoded col 42. GND_LINK_COL moved to 1
    when the link was taken off the signal-crossing path; the figure never
    followed. It reads the constant now.
    3. "ALL copper is on this face" was t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
    [schematic.py]
2026-07-28 Add START-HERE.md and generated WIRING.md; one browsable doc site
    The gap was an orientation document. Every doc explained its own piece and
    none explained how the pieces meet, which is exactly what was confusing.
    - START-HERE.md: the map. What the thing is, then one permission prompt
    traced through all nine steps from switch closing to LED changing, the
    three layers (dumb board / daemon / hooks), how the board's rows map
    onto that, what is deliberately not permanent and why, the build order
    with what each step ends in, and the four failures that have actually
    happened on this project.
    - WIRING.md: GENERATED flat reference, the thing to have open at the
    bench. (A) all 16 wires,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
    [gen-wiring.py, view-docs.py]
2026-07-28 START-HERE: spell out what gets soldered and what never does
    Asked twice now whether the ESP32's pins get soldered into the board.
    They do not -- the socket strips do, and the module plugs into them. Same
    for the LCD: no wire is ever soldered to it, four wires go to the LCD
    port and the LCD reaches that on F-F jumpers.
    New section states the two never-soldered parts up front, breaks the ~149
    joints into the four groups they fall into, and makes the load-bearing
    point explicit: both ends of every wire are lap joints, because the hole
    at each end already holds a header pin or a component leg. Also notes
    that components and their wires go in together per step, not all
    components then all wires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
2026-07-28 Document the G command; confirm firmware and daemon still match the board
    Cross-checked the whole chain pin by pin after the layout rework. Nothing
    needed changing -- the firmware only ever knew GPIO numbers, and no GPIO
    moved. LEDs 13/14/27/26, agent buttons 32/33/25/4, approve 19, deny 18,
    always 23, LCD on 21/22 at 0x27, and daemon.py maps B 4/5/6 to
    APPROVE="1" / DENY="3" / ALWAYS="2". verify-layout asserts all of it, so
    a future GPIO change fails the build rather than the demo.
    The one gap the check found was documentation, not code: the firmware
    accepts a fourth command, "G <0-100>" for the bar graph, which neither
    protocol table listed. CLAUDE.md mentioned the bar graph in prose but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
2026-07-28 Note resistor orientation in step 3
    Resistors are not polarised, so either way round works — but fitting all
    four the same way with the gold band at the bottom means the four can be
    checked at a glance. Random orientations are how a stray 2.2k survives
    inspection.
    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
2026-07-28 Correct an overstated hazard: 4 joints exposed, not 11, and not electrically
    Prompted by a design challenge — should ground legs share a hole with the
    bus, or get their own hole and a jumper? Re-checking my own claim to
    answer it, I found I had inflated it twice over:
    - "11 joints at risk" counted every ground leg that lands on a bus row.
    But rows 16 and 21 seat their switches FIRST and lay the bus on top of
    the bent legs, so nothing is ever pushed past a wire there. Only row 8
    is bus-first: 4 resistor bottom leads.
    - More importantly, every bussed hole on this board is a GROUND hole, and
    the bus wire IS the ground net. A lead that stops on the wire instead of
    reaching the pad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
2026-07-28 LCD port is FEMALE — the male-header version needed parts you don't have
    "The F end has nowhere to go since the pins aren't long enough" is right,
    and it is a problem I created by assuming a part.
    The port was specced as a 4-pin MALE header + F-F jumpers. Two problems:
    the kit has no plain male strip and no F-F jumpers to spare, and a male
    header fitted the usual way up leaves only ~3mm of pin above the board —
    too short for a dupont shell to grip properly.
    Flipped it. The port is now a 4-way FEMALE socket, cut from the same
    40-pin stacking header the ESP32 sockets came from (30 of its 40 positions
    go there, so there is plenty left). The LCD reaches it with ordinary F-M
    jumpers: MALE i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
    [gen-tables.py, gen-wiring.py, layout.py, schematic.py, verify-layout.py]
2026-07-28 "Bus-first does not work on this row" was another overstatement
    It does work, if the bare wire is laid properly beside the pad centres —
    the holes stay clear and the switch legs go in after. What is actually
    true is that legs-then-bus is far more forgiving, and soldering onto a
    bent leg gives a much bigger target than a pad edge.
    Second time today I stated a preference as a physical impossibility (the
    first was "11 joints at risk" from the bus-over-hole hazard, actually 4
    and not electrically at risk). Reworded to say what is真 true and why the
    recommended order is still the recommended order.
    Claude-Session: https://cla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
    [gen-tables.py]
2026-07-28 Drop "so the board lies flat" as a build-order reason
    Correct pushback: the board does not need to lie flat, and from the first
    bus onward it cannot — there are wires on the underside for the rest of
    the build. "Lowest parts first" only matters if you place a part and flip
    the board onto the bench to hold it in, and this build already calls for
    helping hands or a vise, which makes it moot.
    Also worth noting all soldering is on the underside, so a 12mm button on
    the top face never blocks iron access to anything.
    What actually drives the order in section 5, now stated as such: every
    step ends in a test that RUNS, so a failure is one step's worth of joints
    instead of 141; and a few joints h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
2026-07-29 ESP32 columns were drawn backwards — VIN side is the NEAR column
    Confirmed on the real seated module while wiring the LCD: the VIN column
    is the one nearer the controls (board col 30), the 3V3 column is the far
    one (col 40). I had it the other way round, and it came from a generic
    "DevKit V1" pinout I looked up rather than from this board.
    GPIO assignments were never affected — every wire goes to the same ESP32
    pin it always did. Only the physical column each pin sits in was wrong,
    so every hole coordinate in the wire table and both figures pointed at the
    wrong side of the socket.
    Caught because the LCD test doubles as the measurement: if the columns
    were swapped, SDA/SCL would have la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
    [layout.py, verify-layout.py]
2026-07-29 lcdtest: exercise both rows full width, and clear() first
    Second row came up blank on the real board and the old sketch could not
    tell us why: it wrote two short strings, never called clear(), and left
    whatever powered up in DDRAM sitting underneath. A row that failed to
    write looked identical to a row that was merely faint.
    Now it fills both rows with solid blocks for 3 seconds, then writes text
    across all 16 columns of both. That separates the three cases the serial
    output now names outright: fully working, row 1 not driven, or contrast.
    Also: bail out instead of driving a nonexistent address when the scan
    finds nothing, warn if more than one device answers, and add the settling
    delays a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
    [lcdtest.ino]
2026-07-29 Record two findings from the first full run on the soldered board
    1. The directory-scope permission prompt ("Yes, allow reading from
    Pictures/ from this project") does NOT fire the PermissionRequest hook.
    Measured: of five prompts in one session, four fired the hook and that
    one was caught only by screen-detect. The hybrid fallback is therefore
    load-bearing, not belt-and-braces -- noted in CLAUDE.md so nobody
    removes it later on the grounds that the hook covers everything.
    2. The pad answers the agent whose tmux window is ON SCREEN, not the one
    blinking. Eight button presses were correctly refused because red was
    blocked while green was focused. That is the interlock wo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
2026-07-29 prompt_visible missed prompts padded with trailing blank lines
    Green had a live permission prompt on screen while the daemon insisted it
    was "working", so every approve press was correctly refused for the wrong
    reason. Measured on the real pane:
    42 lines captured, last non-blank at index 24 -> 17 trailing blanks
    index 20 ' > 1. Yes' 22 from the end
    index 21 ' 2. Yes, allow reading from Pictures/' 21 from the end
    index 22 ' 3. No' 20 from the end
    detector looked at lines[-20:] = indices 22..41
    So it saw "3. No" and nothing else: one option row, zero selected rows.
    It requires two options AND a selected row, so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
    [daemon.py]
2026-07-29 Status: the soldered board is built and working
    Was still saying the soldered build was "next". It is done. Records what
    was verified on the real hardware and the two bring-up bugs (lcdtest not
    clearing DDRAM, prompt_visible slicing the prompt in half), so the next
    person reading this knows both were real and where they were.
    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
2026-07-29 Strip dead documentation and the mounting design that is not happening
    Review pass with the board finished. Everything still green: five
    generators, firmware compiles, gen-tables idempotent, verify-layout PASSes.
    Removed outright:
    - docs-archive-breadboard-era.md (640 lines). Carried a "do not build from
    this" banner and described the two-board design that was abandoned. Its
    only claim was bring-up history, which git already holds.
    - tools/view-plan.py. Rendered BUILD.md as a tickable bench checklist for
    a build that is now done; view-docs.py covers the reading case.
    Untracked, because they are generated on every run and churned the diff:
    - docs.html (3494 lines) and underside-previe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
2026-07-29 Code review: five real bugs in daemon.py and the firmware
    Asked whether the code was actually good, so I read it rather than just
    running it. Five findings, all fixed and all verified on hardware.
    daemon.py
    1. ILLEGAL SEEK, both tail loops. tail_events and tail_context rewound a
    partial line with f.seek(-len(line), os.SEEK_CUR). A text-mode file in
    Python 3 cannot do cur-relative seeks -- it raises UnsupportedOperation.
    Reproduced. It never fired only because the hook writes each line with a
    single atomic printf; the day a write is split, the thread crashes,
    supervise restarts it, and it seeks to END, silently dropping every
    event in the gap. len() also counts characters,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
    [agentpad.ino, daemon.py]
2026-07-29 Sanity review: one leak, one interleave, three pieces of dead code
    Second pass over everything. All generators run, all five sketches
    compile, gen-tables and gen-wiring are idempotent, verify-layout PASSes,
    and the hook -> daemon -> LED chain was re-confirmed live.
    Found:
    - answered_at leaked. The double-fire guard added a per-pane dict that
    sync_slots did not clean when a slot was released or a window respawned.
    One stale entry per closed window -- harmless, but info and ctx_pct were
    already cleaned there and this was not. ctx_pct was also missing from the
    respawn path; both now cleaned on both paths.
    - refresh() wrote its two LCD rows as separate serial sends, and it is
    called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
    [daemon.py, gen-wiring.py, layout.py, schematic.py]
2026-07-29 Add run.sh and document how to start the thing
    One command instead of remembering the mise incantation, and it guards the
    two failures that look like hardware faults:
    - no board at the port, with the charge-only-cable hint that cost an hour
    yesterday
    - a second daemon started over a running one, which is what produces
    "serial noise or corruption" on the next upload
    Runs in the foreground so ctrl-c stops it. START-HERE gains a Running it
    section: the two commands, the press-colour-then-answer rule, and a short
    symptom table pointing at daemon.log.
    Claude-Session: https://claude.ai/code/session_01PWKhYQrJFCVPvunxqV5g9J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
2026-07-29 Track docs.html and schematics.html so a clone has the diagrams
    Both are generated, and 8c03cb4 untracked them because they churned the
    diff on every run. That is the right call for solo work and the wrong one
    for handing the repo to someone else: a clone got the markdown but neither
    the board diagrams nor the browsable doc set, and the doc generators cannot
    be run from a fresh clone anyway -- view-docs.py imports markdown, which is
    declared nowhere (mise.toml still says pyserial is the only dependency).
    Committing the two outputs is the cheaper fix. They are a self-contained
    pair: schematics.html has no external references at all (inline SVG) and
    docs.html links only to schematics.html plu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
2026-07-29 Firmware: report button releases as "R <n>"
    Sustained notes were never a hardware limit -- readButtons() already fired
    on both edges and updated lastBtn, it just said nothing on the rising one.
    Three lines make it report.
    Additive on purpose. daemon.py skips any line that does not start with
    "B ", so Agent Pad is completely unaffected by the new prefix; verified
    against 'B 3', 'R 3' and junk. Any future addition should follow the same
    rule rather than extending the "B" line, because the daemon parses
    split()[1] and would read "B 0 1" as a press of button 0.
    Claude-Session: https://claude.ai/code/session_01PWKhYQrJFCVPvunxqV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
    [agentpad.ino]
